klimabartlomiej/furnace-monitor/(commit log)

2026-10-22 feat: firmware v1 - HomeKit, historia Eve, zdalne aktualizacje
    [partitions.csv]
2026-10-22 feat: dane co minute z 31 dni, ostrzezenia, dziennik i nowe widoki aplikacji
    [partitions.csv]
2026-10-22 feat: zaniki pradu, wegiel w wiadrach, tryb lato, popielnik i gladkie wykresy
    Zaniki pradu sa czeste, wiec stany alarmow i ostrzezen przetrwaja restart -
    trwajacy problem nie wysyla ponownego powiadomienia. Zanik mierzony co do ~2 s
    znacznikami "zyje" w nowej partycji alive (16 KB z LittleFS, ~4k kasowan
    sektora rocznie); pasy na wykresach i wykres 30 dni.
    Wegiel liczony w wiadrach (tata nosi luzem z piwnicy): zuzycie proporcjonalne
    do ciepla (piec - powrot), wspolczynnik uczony z dosypan do pelna; kg i koszty
    z wagi wiadra. Do tego "Malo wegla", prognoza na jutro z pogody, popielnik,
    tryb lato (sam wraca po 2 h palenia), "Piec stoi po zaniku pradu", "Ciepla
    woda gotowa" i podsumowanie 7 dn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
    [partitions.csv]
2026-10-23 fix: poprawki z przegladu - podsumowania dobowe, zmiana czasu, odpornosc
    Podsumowania dobowe nigdy sie nie zapisywaly: RingFile przepisywal srodek
    i naglowek 62 KB pliku, a copy-on-write LittleFS nie mial na to miejsca.
    Dziennik, dosypania i dni ida teraz do SegmentLog (dwa pliki, tylko
    dopisywanie) - LittleFS 143 -> 57 KB, brakujace dni odtwarzane z minut.
    Reszta z docs/review-2026-10-23.md: polnoc przy zmianie czasu
    (tm_isdst = -1, TZ od startu), watchdog i 5-min okno portu szeregowego,
    bez automatycznego hotspotu, haslo OTA przezywa pelny reset, aktualizacja
    nie wraca do wycofanej wersji, ostrzezenia licza minuty i nie migaja po
    zaniku pradu, walidacja progow/ustawien (400), cofanie dosy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
    [HistoryLog.h, PiecTemp.ino, RemoteUpdate.h]
2026-10-23 fix: przycisk BOOT w osobnym zadaniu - 15 s zawsze pelny reset
    U taty 20-sekundowe przytrzymanie dalo tylko "zapomnij WiFi": HomeSpan
    blokowal petle na 22 s, probujac polaczyc sie ze stara siecia, wiec
    pomiar czasu w loop() nie doszedl do 15 s i parowanie z Domem zostalo.
    Przycisk ma teraz wlasne zadanie (co 50 ms), dzialajace tez w czasie
    laczenia z WiFi i hotspotu. Zadanie kasuje tylko NVS (WIFI, HAP, CHAR -
    SRP z kodem parowania i OTA z haslem zostaja); historie czysci nastepny
    start, zanim cokolwiek ja otworzy.
    [PiecTemp.ino]
2026-10-24 fix(update): pobieraj dopiero po zamknieciu przekaznika, iPhone bez kodu
    Pierwsza proba z telefonu (v14->v15) padla: manifest nie przeszedl dwa razy,
    bo przekaznik obslugiwal zapytania aplikacji i nie zamknal sie w stalych
    1,5 s (pobieranie z sieci lokalnej przeszlo: 1,7 MB w 46 s, potwierdzone).
    Teraz po Zainstaluj ESP najpierw oddaje odpowiedz telefonowi, potem czeka
    az przekaznik faktycznie sie zamknie (do 20 s); manifest ma 3 proby.
    Aplikacja nie zglasza bledu, gdy piec znika w trakcie instalacji.
    iPhone: ikona na ekranie poczatkowym ma osobna pamiec i brala start_url
    z manifestu - bez parowania. W Safari otwartym z linku manifest jest
    usuwany, wiec zapisuje sie adres razem z kluczem.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
    [PiecTemp.ino, Relay.h, RemoteUpdate.h]
2026-10-24 fix(relay): manifest przez /fw zawsze swiezy
    Po wydaniu v18 przekaznik jeszcze kilka minut podawal manifest v17 z pamieci
    CDN GitHuba, wiec ESP uznalby sie za aktualny. Dla .json dopisywany jest
    parametr omijajacy cache.
2026-10-24 chore(relay): usun nieskuteczne omijanie cache manifestu
    CDN GitHuba ignoruje parametry zapytania (zmierzone: X-Cache HIT mimo ?t=),
    wiec nowy manifest i tak dociera do 5 min po wydaniu.
2026-10-24 feat: ustawienia jako menu, powiadomienia zamiast alarmow w Domu
    W Domu zostaja same termometry z historia Eve (stale AID 2-5, parowanie i Eve
    bez zmian); 11 czujnikow kontaktowych (alarmy, ostrzezenia, ciepla woda)
    znika - wszystko to przychodzi jako push z aplikacji, bez dublowania.
    Ciepla woda gotowa: wpis w dzienniku i push, najwyzej raz na godzine.
    Push 'Dostepna nowa wersja' raz na wersje (takze po restartach).
    ESP dopisuje do alertu rodzaj (alarm/warn/power/water/update), przekaznik
    wysyla tylko do telefonow, ktore go chca - tresc nadal zapieczetowana.
    Ustawienia: menu w grupach (Piec / Telefon / Urzadzenie) ze statusem przy
    kazdej pozycji, osobne strony, powrot strzalka i gestem ws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
2026-10-24 feat: poranne podsumowanie, legenda i pelny ekran wykresow
    Podsumowanie o 7:00 (raz dziennie, takze po restartach): wczorajszy wegiel w
    wiadrach i zlotowkach, godziny palenia, min/max pieca, zaniki pradu - z rekordu
    dobowego i dziennika; slowa sklada telefon. Przelacznik 'Podsumowanie dnia'.
    Wybor powiadomien zapisywany teraz jako wylaczone rodzaje (off), wiec nowy
    rodzaj jest domyslnie wlaczony.
    Wykresy: legenda tego, co widac (brak pradu, alarm, ostrzezenie, koniec), a
    przytrzymanie na pasku/kresce pokazuje zdarzenie. Pelny ekran: karta wykresu
    przenoszona pod <body> (transform animacji zakladki psul position:fixed),
    w poziomie rysowana szeroko; Android chowa tez paski systemu.
    [PiecTemp.ino]
2026-10-24 feat: wegiel w kilogramach, Dane kotla z pojemnoscia zasobnika
    Dosypanie wpisywane w kg; lopaty (~3,2 kg) i wiadra (~9,6 kg) to tylko
    liczniki w oknie, ktore same wpisuja kg - stale w aplikacji, nie ustawienia.
    Pojemnosc zasobnika przeniesiona na nowa strone Ustawienia -> Dane kotla
    (domyslnie 100 kg), pole "Wiadro wazy" usuniete, limit popielnika w kg.
    Firmware liczy wszystko w kg; jednorazowa migracja (coalToKilograms,
    krokowa flaga "coalKg" - zanik pradu w polowie nic nie przelicza dwa razy)
    mnozy przez dotychczasowa wage wiadra: dosypania, wpisy "Malo wegla" i
    popielnika w dzienniku, limit popielnika, wyuczone coalK; zasobnik od nowa
    100 kg. Aplikacja z GitHub Pages wyprzedza piec do cz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
2026-10-25 feat: podstawa diagnostyki - dziennik techniczny i raport
    U klienta nie widac bylo, co dzialo sie w programie - komunikaty szly tylko
    na USB. TechLog.h: ~2 KB pierscien komunikatow w pamieci RTC_NOINIT, ktora
    przezywa crash/watchdog/restart (nie zanik pradu), z przyczyna kazdego
    startu; tee na Serial. Pominiete: odczyty co minute i Eve (zalalyby log).
    Przekaznik loguje polaczenia i powod zerwania raz (nie przy kazdej probie),
    czujniki licza bledy odczytu od startu.
    /api/diag: tekstowy raport (wersja, start, pamiec min, WiFi, przekaznik,
    czujniki z bledami, aktualizacje, log) bez hasel i kluczy; w aplikacji
    Ustawienia -> Urzadzenie -> "Raport diagnostyczny" (plik przez Web Share
    albo pobrani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
    [PiecTemp.ino, Relay.h, RemoteUpdate.h, TechLog.h]
2026-10-27 feat: port na ESP32-S3 - partycje 16 MB i osobny kanal wydan
    Klasyczny ESP32 ma pelny flash (~3,5 KB wolne po v25) - kolejne funkcje
    ida na ESP32-S3 N16R8 (16 MB flash, 8 MB PSRAM). Jeden kod dla obu plytek:
    CONFIG_IDF_TARGET_ESP32S3 wybiera piny (1-Wire GPIO4, dioda RGB GPIO48)
    i kanal aktualizacji release/s3/manifest.json, zeby zadna plytka nie
    dostala firmware na inny uklad.
    partitions_s3.csv: 2 x 4 MB na OTA, historia minutowa, coredump, ~7 MB
    LittleFS; nvs i otadata tam gdzie w klasyku, wiec kopia ze starej plytki
    laduje sie w to samo miejsce. Arduino bierze partitions.csv z folderu
    szkicu, dlatego publish.ps1 -Target s3 podmienia go w kroku prebuild.3 i
    podnosi upload.maximum_size do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
    [partitions_s3.csv]
2026-10-27 feat: czujniki w slotach z rolami i termopara spalin
    Adresy czujnikow byly wpisane w kod, a logika szukala ich po numerze -
    nowy klient albo wymiana czujnika wymagaly nowego firmware. Teraz sloty
    (8 na S3, 4 na klasyku) z rola: Piec, Powrot, Zasobnik wegla, Bojler,
    Spaliny, Inny. Logika szuka czujnika po roli (FURNACE itd. = -1, gdy
    brak) i wylacza tylko to, co tej roli potrzebuje. Historia zostaje przy
    slocie, wiec "Uzyj zamiast" przejmuje wykresy starego czujnika. Role nie
    zaleza od typu czujnika - adres mowi, czy to DS18B20, czy termopara.
    Nieznany czujnik przy starcie sam zajmuje wolny slot; termopara MAX6675
    (GPIO10/12/13, bit-bang) od razu dostaje role Spaliny. Spaliny maja
    wiekszy pr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
    [partitions_s3.csv]
2026-10-27 feat: liczniki zdrowia, ostatni crash i kod serwisowy tylko do podgladu
    Raport diagnostyczny dostaje dzienne liczniki: polaczenia WiFi i
    przekaznika, bledy czujnikow, nieudane aktualizacje, najmniej RAM,
    najdluzsza petla, najslabszy sygnal, najcieplejszy chip, starty. Biezacy
    dzien siedzi w RTC_NOINIT, wiec przezywa crash i restart po aktualizacji -
    wtedy jest najbardziej potrzebny; zamkniete dni ida do /hl. Ostatni crash
    z partycji coredump: zadanie, PC, backtrace i build (prefiks SHA ELF);
    publish.ps1 zachowuje ELF kazdego wydania pod tym prefiksem, wiec adresy
    da sie rozkodowac addr2line.
    Kod serwisowy: drugi klucz w tym samym pokoju przekaznika
    ("host/pokoj.sekret"), na 24 h albo 7 dni,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
    [PiecTemp.ino, Relay.h, RemoteUpdate.h]
2026-10-27 fix: poprawki z przegladu i testow na zywo na S3
    Testy na zywo:
    - HomeSpan miga dioda statusu z zadania z 1 KB stosu - za malo dla
    sterownika RMT diody RGB; S3 padl na przepelnieniu stosu (BlinkTask,
    coredump). Wlasny Blinkable przekazuje tylko stan do zadania z 4 KB.
    - Przywracanie kopii zawsze konczylo sie bledem "file ends too early":
    znacznik konca to jeden bajt 0, a naglowek sekcji czytany po dwa. Dane
    sie przywracaly, aplikacja pokazywala blad. Czytnik przyjmuje teraz
    pojedynczy bajt, takze z kopii obecnej v25.
    Z przegladu:
    - telefon z pamiecia ze starej plytki (4 czujniki) czytal rekordy S3
    (8 slotow) zlym rozmiarem - miliony kg wegla, stojaca historia dzienna;
    zmiana l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
    [partitions_s3.csv]
2026-10-27 fix(update): zamierzony restart nie cofa nowej wersji na probie
    Nowa wersja jest na probie przez minute po wejsciu do sieci; kazdy restart
    w tym czasie bootloader bral za awarie - wracal do starej wersji, a nowa
    trafiala na liste zlych i nie przychodzila drugi raz. Wyszlo w tescie
    aktualizacji przez przekaznik: zapis slotow 40 s po instalacji v26.
    Restart z zapisu slotow, przywrocenia kopii i czyszczenia historii najpierw
    potwierdza wersje - skoro odpowiedziala przez siec, dziala. Crash i brak
    sieci dalej ja cofaja; zanik pradu w tej minucie tez (nie da sie odroznic).
    Nazwy czujnikow musza byc poprawnym UTF-8: bajt z innej strony kodowej
    (curl z konsoli Windows) psul caly JSON /api/now, a H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
    [PiecTemp.ino, RemoteUpdate.h]
2026-10-29 feat(geco): podsluch magistrali sterownika GH11TB i opis protokolu
    Sterownik GH11TB nadaje na zaciskach panelu (21/22) takze bez panelu:
    9600 8N1, bajty zanegowane, suma kontrolna = suma 9 bajtow - 0x10.
    Rozpoznane w kotlowni taty wylacznie przez sluchanie: temperatury kotla,
    podajnika i CWU (wartosc / 2, zgodne z wyswietlaczem i naszymi
    czujnikami), wentylator, podajnik, pompa CO, tryb czuwanie / palenie /
    podtrzymanie oraz przebieg przedmuchu. To nie Hewalex/GECO 38400 ani
    Modbus. Zapis u0/u4 wymaga podsluchu prawdziwego panelu GA01HA - na slepo
    nic nie wysylamy.
    sniff.ps1 nigdy nie pisze na port; decode.py pokazuje zmiany stanu.
    Duze nagrania zostaja poza repo (.gitignore), w repo 55 s p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
2026-10-30 feat(geco): sterownik kotla na zywo w aplikacji i alarm czuwania
    Podsluch GH11TB przez modul RS485 (tylko odbior, UART bez TX): animowany
    kociol z poziomem wegla, paski pracy pod wykresami, odczyt sterownika jako
    przerywana linia przy naszym czujniku (domyslnie wylaczona, zastepuje
    milczacy czujnik), baner przy rozjezdzie >5 st. przez 15 min, auto-korekta
    offsetow i ostrzezenie "Sterownik nie w automacie" z powiadomieniem.
    Aplikacja startuje zawsze na Przegladzie, zajete role czujnikow wyszarzone.
2026-11-02 docs(geco): zasilaj modul RS485 z 3V3 zamiast z pinu 5V plytki S3
    Pin 5V na S3 to tylko wejscie ("5V in") - transceiver dostawal 0,69 V
    i nic nie slyszal (linia 'h' przez 30 min u taty). Test na stole z ESP
    sterujaca A/B: modul dekoduje kazda ramke od razu po przelozeniu 5V na
    3V3. Modul jest dopuszczony do 3,3 V, wiec 5V mostkujemy z VIO.
2026-11-04 fix(web): dociagaj wykresy po 2 h od najnowszych i rysuj dobe z pamieci
    Po przerwie cala luka szla jednym zapytaniem (ESP przez relay ~8 KB/s:
    doba 81 KB = ~10 s, limit 12 s) - na telefonie potrafila nie zdazyc i
    co minute startowala od zera, a wykres stal pusty do konca. Teraz kawalki
    po 2 h (~0,8 s), rysowane po kazdym; niepobrany zakres przezywa
    przerwanie i cache. Widok 24 h liczony z minut na telefonie (jak skleja
    ESP) zamiast 22 KB co minute; 7/30 dni z limitem 30 s.
2026-11-04 fix(web): otwieraj zapisana kopie aplikacji przy awarii GitHub Pages
    Przy awariach GitHuba aplikacja otwierala sie jako jego strona bledu.
    Service worker bierze pliki najpierw z sieci (nowa wersja od razu), a
    zapisana kopie podaje tylko gdy siec padnie lub Pages odda 5xx. Dane i
    tak ida przez relay, wiec aplikacja dziala podczas awarii.
2026-11-06 fix(geco): pokazuj prawdziwa prace podajnika i popraw liczniki sterownika
    Obrazek kotla stal, bo odswiezanie co 15 s lapalo 8% sekundowych porcji
    podajnika. Teraz odtwarza dziennik sterownika z opoznieniem 18 s; kazde
    odswiezenie dobiera kilkadziesiat bajtow. Polozenie tloka jest szacowane z
    czasu pracy silnika, zerowane przy powrocie do pozycji.
    "Od" pokazuje prawdziwy poczatek stanu, koniec palenia ma nazwe "dobieg", a
    pasek trybu nie chowa juz palen: w widoku 7 dni nie bylo widac zadnego z 25.
    Bez polaczenia kociol nie udaje pracy.
    v31 pokazywal spaliny 4289 st.: iloczyn bez znaku przy spalinach spadajacych
    miedzy odczytami. Dokonczenie skoku liczy sie teraz do palenia (31% wegla poza
    p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
    [PiecTemp.ino]
2026-11-11 feat(geco): licz wegiel z posuwow tloka i ostrzegaj o pustym zasobniku
    Wspolczynnik z temperatur wody zanizal zuzycie o 38 % (0,15 zamiast 0,25 kg na posuw):
    11.11 zasobnik byl pusty, a aplikacja pokazywala ~35 kg. Teraz wegiel = posuwy x kg na
    posuw nauczone z dosypan do pelna (bez posuwow po oproznieniu zasobnika), pojemnosc z
    dosypan do pustego, tempo z wyzszego z doby i 3 dni. Dwa polgodzinne palenia bez wzrostu
    spalin wlaczaja Malo wegla. Dosypanie zapisuje stan zasobnika i znacznik ponowienia.
    Karta Wegiel: na ile starczy, do kiedy i pasek dni. Przeglad MAX: poprawki wlaczone.
2026-11-11 feat(geco): pelny zasobnik z ustawien, cwiartki tylko bez do pelna, bez popielnika
    Tata ustawil pojemnosc 120 kg i to ma byc pelny zasobnik, wiec dosypania do pustego juz
    jej nie nadpisuja (dalej pomagaja uczyc kg na posuw). Przy dosypaniu do pelna okienko
    pyta tylko, czy zasobnik byl pusty; cwiartki sa szacunkiem na oko i maja sens tylko przy
    dosypywaniu nie do pelna. Popielnik niepotrzebny: wiersz, przycisk, ustawienia i
    ostrzezenie usuniete.
2026-11-12 feat(geco): piec i podajnik ze sterownika, historia starych czujnikow przechodzi dalej
    Tata zwalnia czujniki pieca i zasobnika - temperatura kotla i podajnika ma
    byc tylko z magistrali sterownika. Odczyt sterownika liczy sie dopiero po
    2 min rownej magistrali: 11.11 przy dosypywaniu podal 30 C kotla przy 64.
    "Nie odpowiada" dla sterownika po 5 odczytach (cisza + 2 min ustalania).
    Slot, ktory przejmuje role wylaczonego czujnika (h<i> w /api/slots), pokazuje
    jego historie sprzed zmiany tam, gdzie sam nic nie ma albo odstaje o >10 C;
    stary slot zaczyna czysto. Tylko w /api/series, /api/csv i /api/daily -
    logi zostaja nietkniete. Sterownik ma historie od 04.11, wczesniej stary
    czujnik (srednio +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
